Enji-Near/mw-spaceships/ref/arduino-nano-every-pinout.png

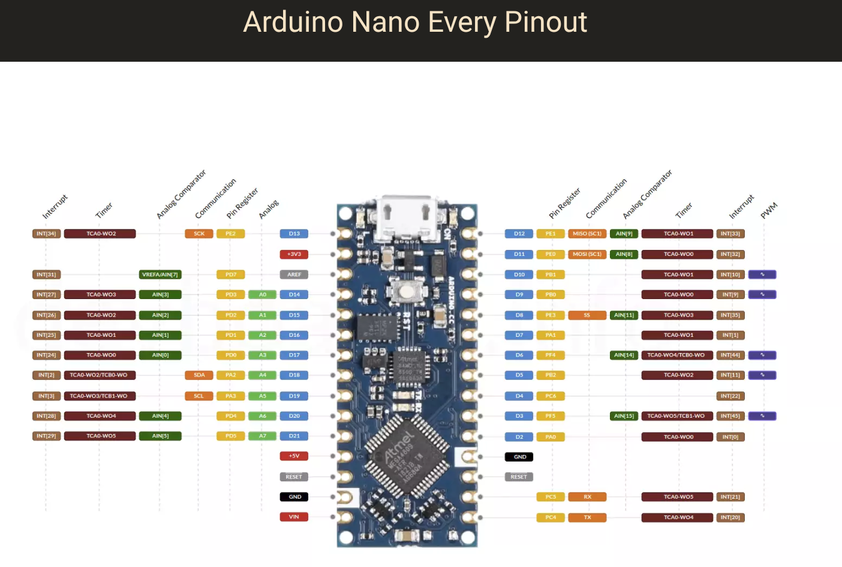
ref/arduino-nano-every-pinout.png
