Enji-Near/mw-spaceships/README.md

# mw-spaceships
Small Arduino program to control movement of two spaceships at Miniature World
