Enji-Near/mw-spaceships/ref/wiring-diagram.png

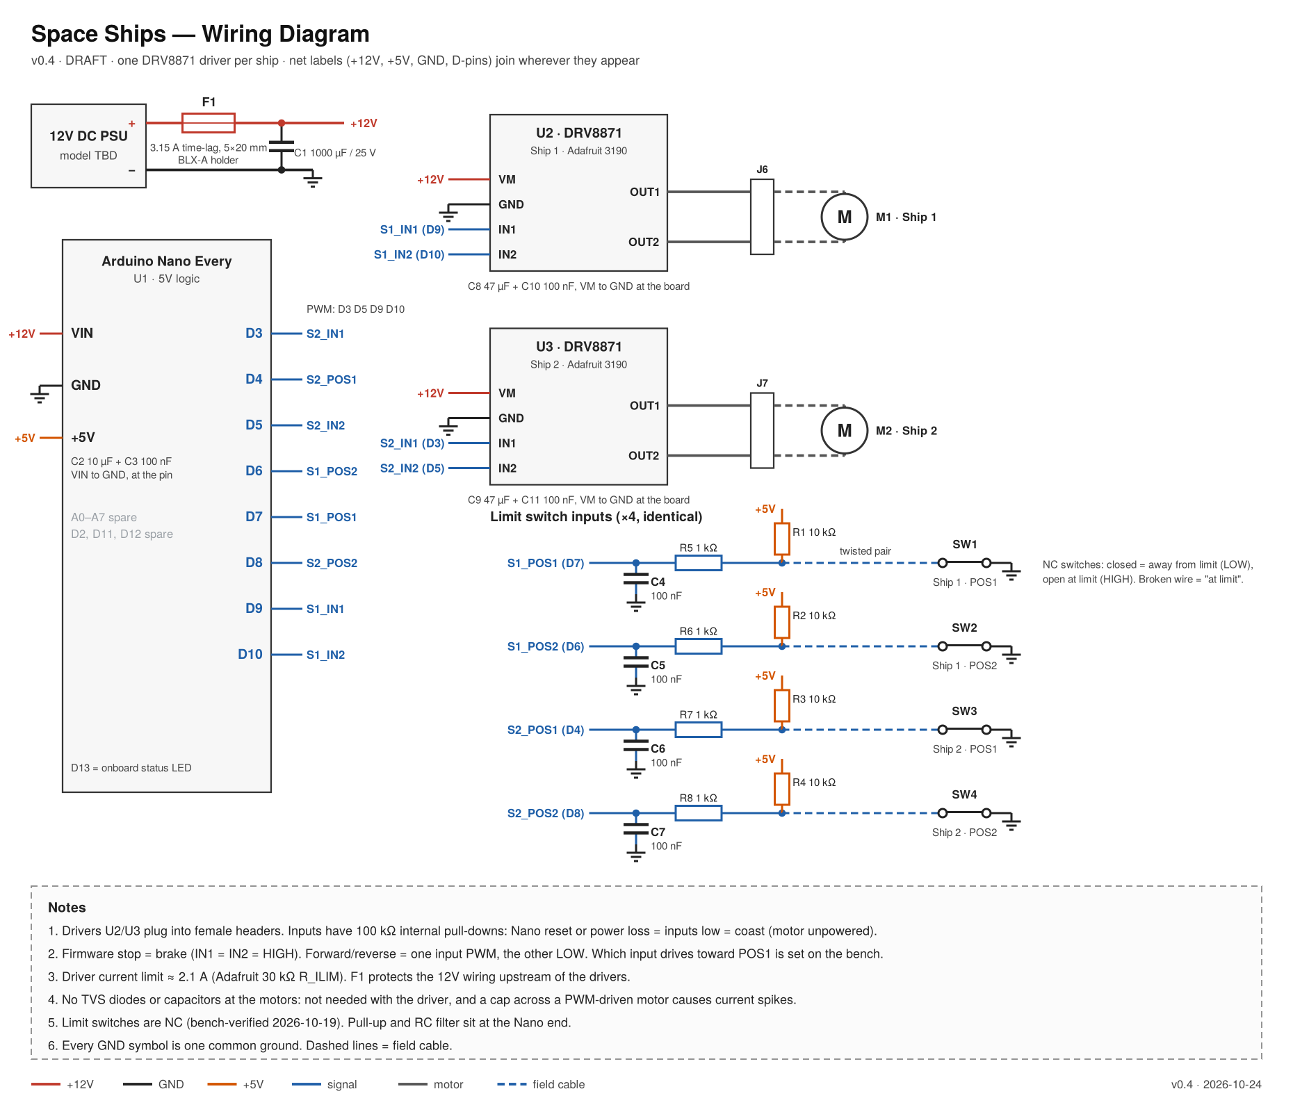
ref/wiring-diagram.png
