Enji-Near/mw-spaceships/(commit log)

2026-10-14 Add SpaceShips sketch v0.2 for Arduino Nano Every
    Two independent ship state machines (move, dwell, fault, lockout),
    2-relay polarity reversal per motor, debounced limit switches,
    move timeout, wrong-way and both-limits checks, ~2 s watchdog.
    v0.2: relay modules in high-level trigger mode (RELAY_ON HIGH),
    limit switches assumed NO (LIMIT_ACTIVE LOW, verify on bench),
    fault cool-down 10 s, project code removed from header.
    Claude-Session: https://claude.ai/code/session_01QFekpdcCQPzgiZhMDM4HP3
    [SpaceShips.ino]
2026-10-16 Move to PlatformIO layout
    - src/mw_space_two_simple_ships.cpp (was SpaceShips/SpaceShips.ino), adds #include <Arduino.h>
    - platformio.ini: atmelmegaavr / nano_every, shared [env], live env with build_src_filter
    - .gitignore: .pio/ and machine-specific .vscode files
    - .vscode/extensions.json: recommends PlatformIO IDE and Claude Code
    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
2026-10-17 Move relay outputs to A0/A2/A4/A6 and add wiring diagram v0.2
    - Relays: D2-D5 -> D14 (A0), D16 (A2), D18 (A4), D20 (A6) for a cleaner board layout
    - Note in code and CLAUDE.md: A4 is also I2C SDA; no Wire while it drives a relay
    - CLAUDE.md: pin map, spare list, A0-A7 digital GPIO source
    - docs/wiring-diagram.svg/.png: both ships, new pins, R9-R12 relay pull-downs, no fuse
    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
2026-10-17 Rename docs/ to ref/ and add BoM
    - ref/BOM.md: bill of materials exported from the project BoM (inventory column dropped)
    - ref/wiring-diagram.svg/.png moved from docs/
    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
2026-10-18 Add hold-to-jog to bench_test; 10 kOhm limit pull-ups in docs
    bench_test:
    - Hold 5-8 to jog a ship (same order as 1-4); dead-man on key auto-repeat
    - Stops on release, at the target limit, on any other key, or on any fault
    - Reuses moveArrived() checks: both limits, wrong way, timeout
    - Blocks reversing a motor within REVERSE_PAUSE of it stopping
    - Ignores repeats of a held key after a jog stops, so it can't restart itself
    Docs:
    - Limit pull-ups R1-R4: 4.7k -> 10k, with safe ranges (ATmega4809 Table 4-16)
    - Wiring diagram v0.3: R1-R4 10k, note on fail-safe relay contacts
    - CLAUDE.md: bench_test description includes jog
    Claude-Session: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
    [bench_test.cpp]
2026-10-20 Bench-verified limits and directions; set MOVE_TIMEOUT
    - Limit pins remapped to as-built wiring (D6/D8 = POS2, D7/D9 = POS1)
    - All limit switches NC; active level now set per switch
    - Ship 1 relay pins swapped (A0 drove toward POS2)
    - MOVE_TIMEOUT 64 s = 1.5x slowest measured average
    [bench_test.cpp, mw_space_two_simple_ships.cpp]
2026-10-29 Redesign v0.4: DRV8871 drivers, shared motion code, speed calibration
    - Replace relays with one DRV8871 per ship (PWM speed, brake stop)
    - include/ship_config.h: single file for all tunable values
    - Shared src/ship_motion.cpp + include/ship_motion.h built into both envs
    - Live firmware: STEADY or RAMP (S-curve) per ship, fixed values, same safety layers
    - bench_test: jog, limit watch, steady (t), minimum (m), ramp (r), print block (p)
    - Remove include/ship_hardware.h (replaced by ship_config.h)
    - Docs: CLAUDE.md, ref/BOM.md and wiring diagram updated to v0.4
    Firmware builds clean (avr-gcc); not yet bench-tested on hardware.
    Claude-S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
    [bench_test.cpp, mw_space_two_simple_ships.cpp, ship_config.h, ship_motion.cpp, ship_motion.h]
2026-11-06 Remap limit pins: D6/D7 = Ship 1 POS1/POS2, D8/D4 = Ship 2 POS1/POS2
    POS1 (motor end) terminal now sits next to the Nano for each ship.
    Bench-checked with bench_test watch mode, no motors connected.
2026-11-06 Surge profile, 31.25 kHz PWM, bench tuning tools; dialed-in defaults
    - MODE_SURGE: start -> take-off -> hyper, hold, -> cruise (S-curves); replaces MODE_RAMP
    - Per-ship wrong-way time (LIMIT_CLEAR_MS) measured by bench_test c
    - PWM 31.25 kHz (TCA0 /2) to stop motor squeal; millis() timer rescaled to stay exact
    - bench_test: duty test (d), jog duty % (j), profile set/test (a), go (g),
    0 = skip a ship, Backspace in prompts; ramp test (r) removed
    - Dialed-in calibration defaults; MOVE_TIMEOUT 93 s (1.5x slowest trip)
    [bench_test.cpp, mw_space_two_simple_ships.cpp, ship_config.h, ship_motion.cpp, ship_motion.h]
2026-11-06 Imperial March: bench key i and live reset-button trigger
    - Tone mode: TCA0 period sets the note; duty rescaled; D3 legs use drive/coast on D5
    - Shared song player in ship_motion.cpp, one octave down, 50% duty, both ships
    - bench_test i: home the way each ship was going, sing away from the limits once
    - Live: external reset (not power-up/watchdog/upload) plays the march, then normal cycle;
    direction kept across reset in .noinit; fault retries wait for the song
    [bench_test.cpp, mw_space_two_simple_ships.cpp, ship_config.h, ship_motion.cpp, ship_motion.h]
2026-11-06 March: A4 button and power-up trigger; same sound every time
    - Trigger: power-up (PORF/BORF) and a button on A4 (INPUT_PULLUP, debounced);
    reset-button trigger removed (USB connect also resets as external)
    - Button: ships brake MARCH_BRAKE_MS, then home; faulted ships sit the song out
    - Ship 2 always starts at POS2 and sings toward POS1 (drive/brake, like Ship 1)
    - MARCH_LIMIT_CLEAR_MS 1110 ms from 4 bench runs (max 610 ms + 500); live won't build at 0
    - bench_test i prints when each ship leaves its limit
    [bench_test.cpp, mw_space_two_simple_ships.cpp, ship_config.h]
2026-11-06 March: restore reset-button trigger (power-up, reset, A4 button)
    Reset button on 12V likely worked all along; the earlier no-song cases fit
    Ship 1 locked out (march waited for its homing timeout). USB connect also
    triggers it. Never after watchdog or upload.
    [mw_space_two_simple_ships.cpp, ship_config.h]
2026-11-06 Remove wrong-way check and its calibration
    Ship 1 stuck on its POS1 switch at the slow start, the wrong-way check faulted
    it before the ramp could break it free, and it locked out. Removed the check
    (live trips, song, bench, jog), bench 'c', and LIMIT_CLEAR_TIME /
    SHIPx_LIMIT_CLEAR_MS / MARCH_LIMIT_CLEAR_MS / CLEAR_*. Move timeout,
    both-limits check, lockout and watchdog stay.
    [bench_test.cpp, mw_space_two_simple_ships.cpp, ship_config.h, ship_motion.cpp, ship_motion.h]
2026-11-07 March: serial command 'i' replaces boot/reset trigger; lower hyper speeds (S1 75, S2 60)
    [mw_space_two_simple_ships.cpp, ship_config.h]
